OPRobots/PX-CORE/README.md

# PX-CORE | Placa multiusos para robots

Es la placa principal de control común a todos nuestros kits PX. Está pensada para poder usarse en casi cualquier tipo de robot.

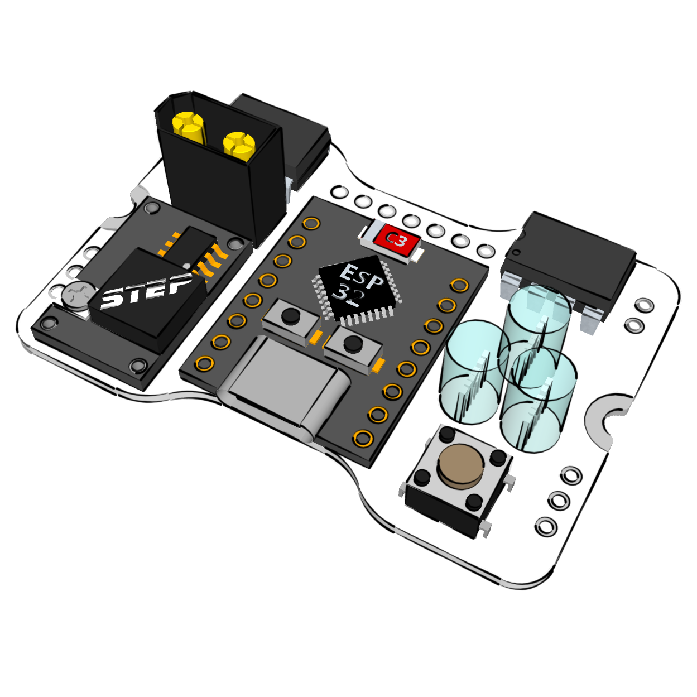
[picture p1: images/px-core_01.png]
PX-CORE


[Más información y conjunta](http://oprobots.github.io/tienda/modulos/px-core/ "Más información y conjunta")

*en construcción*
