OPRobots/PX-CORE/hardware/gerbers/bom.csv

Designator | Footprint | Quantity | Value | LCSC Part #
BTN1 | SW_PUSH_6mm_H4.3mm | 1 | ~
DC-DC_3.3 | DC-DC_3.3 CN3903 | 1 | ~
ESP32 | ESP32_supermini | 1 | ~
J1, START1 | PinHeader_1x03_P2.54mm_Vertical | 2 | Conn_01x03_Socket
J2 | XT30 connector | 1 | Conn_01x02_Socket
J4 | PinHeader_1x07_P2.54mm_Vertical | 1 | Conn_01x07_Socket
LED1, LED2, LED3 | LED_D5.0mm-4_RGB_Staggered_Pins | 3 | ~
M1, M2 | motor_pads | 2 | Conn_01x02_Socket
PH1, PH2 | DIP-8_W7.62mm | 2 | ~
