OPRobots/PX-CORE/(commit log)

2024-01-15 Añade estructura inicial de carpetas
2024-01-15 Añade proyecto KiCad de la PX-CORE
    [PX-CORE.kicad_pcb, PX-CORE.kicad_sch]
2024-01-28 Cambia la PCB a 3 neopixeles, quita pads inferiores y actualiza el DC-DC
    [PX-CORE-B_Mask.gbs, PX-CORE-B_Silkscreen.gbo, PX-CORE-Back.gbl, PX-CORE-Edge_Cuts.gm1, PX-CORE-F_Mask.gts, PX-CORE-F_Silkscreen.gto, PX-CORE-Front.gtl, PX-CORE-NPTH.drl]
2024-01-29 Añade fichero BOM
2024-02-21 Corrige señal leds RGB y actualiza su huella para mejor soldadura
    [PX-CORE.kicad_pcb, PX-CORE.kicad_sch]
2024-02-21 Genera gerbers y BOM
    [PX-CORE-B_Mask.gbs, PX-CORE-B_Silkscreen.gbo, PX-CORE-Back.gbl, PX-CORE-Edge_Cuts.gm1, PX-CORE-F_Mask.gts, PX-CORE-F_Silkscreen.gto, PX-CORE-Front.gtl, PX-CORE-NPTH.drl]
